danielkopp4/4-bit_Processor/Potential Schematics/Registers for PCB/Multiplexer/Board_render.png

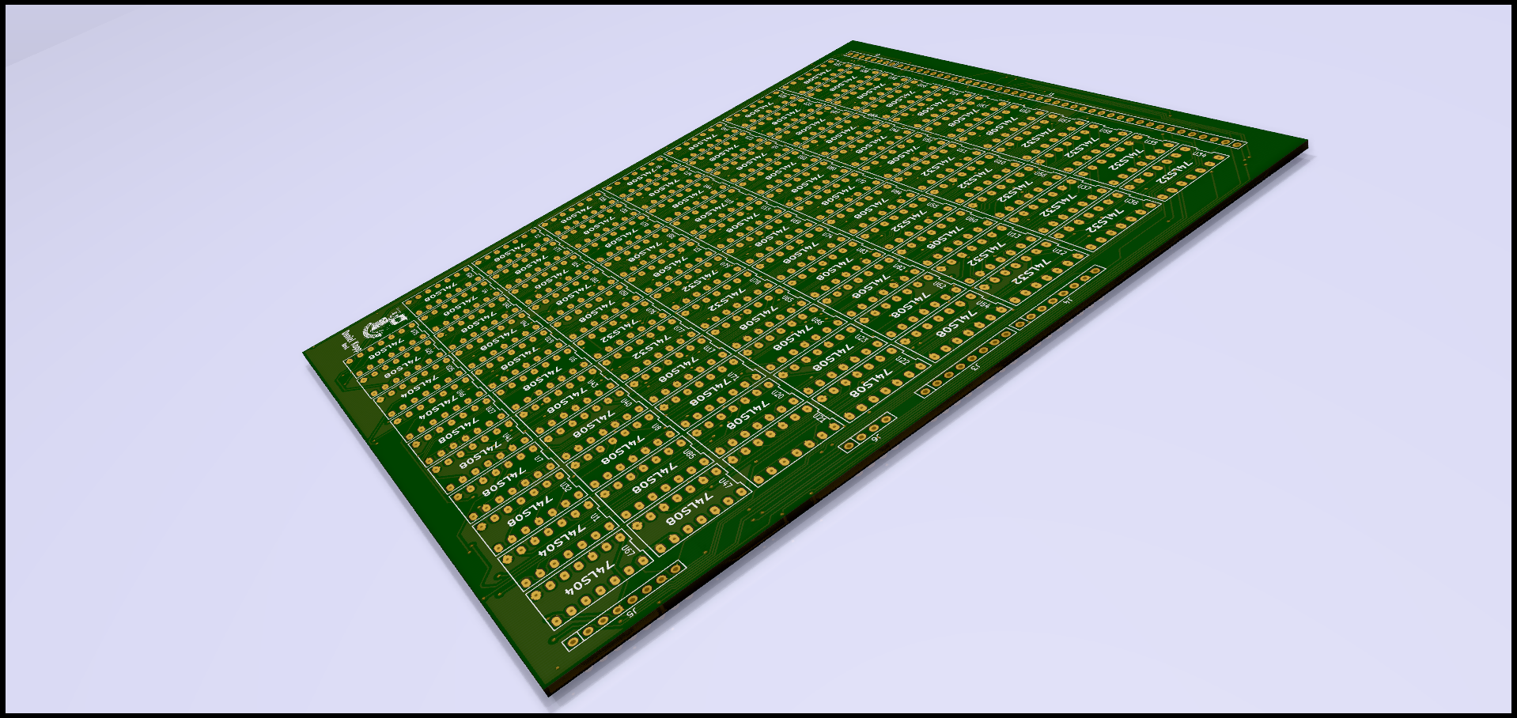
Potential Schematics/Registers for PCB/Multiplexer/Board_render.png
