danielkopp4/4-bit_Processor/(list of files, drawings)

Other design files:
Potential Schematics/Registers for PCB/Multiplexer/Multiplexer.dsn
Potential Schematics/Registers for PCB/Multiplexer/Multiplexer_Final_DSN.dsn
Potential Schematics/Registers for PCB/Multiplexer/Multiplexer_WIth_Better_Edges.dsn
Potential Schematics/Registers for PCB/Multiplexer/Multiplexer_WithEdges.dsn
Potential Schematics/Registers for PCB/Register/Register.dsn
