danielkopp4/4-bit_Processor/Potential Schematics/Registers for PCB/Register/Register.kicad_pcb

## KiCad design Potential Schematics/Registers for PCB/Register/Register.kicad_pcb (2020-09-25)

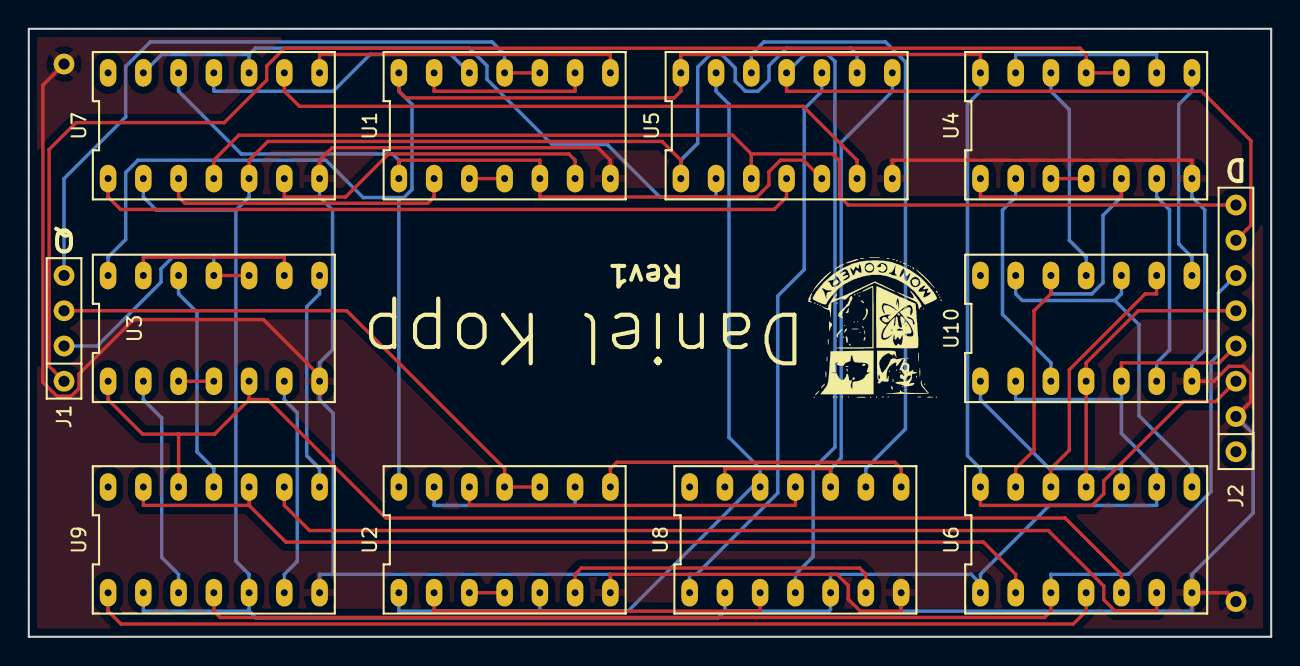
[picture p2: board Register.kicad_pcb from above]

Board: 2 copper layers, 89.5 x 43.8 mm, 15 parts (0 on the bottom side), 51 nets.

Parts:
 : Measurement_Point_Round-TH_Small
 #2: Measurement_Point_Round-TH_Small
 #3: Real_Logo
J1: Conn_01x04_Female; Female_Header_4-pin
J2: Conn_01x08_Female; Female_Header_8-pin
U1, U2, U3, U4: 74LS02; DIP-14_300_ELL
U5, U6: 74LS04; DIP-14_300_ELL
U7, U8, U9, U10: 74LS08; DIP-14_300_ELL

Connections:
/D_Flip-Flop/D_Latch/QN: U1.3, U1.4
/D_Flip-Flop/D_Latch/RS-Latch/R: U1.2, U7.3
/D_Flip-Flop/D_Latch/RS-Latch/S: U1.6, U7.6
/D_Flip-Flop/QN: U1.9, U1.13
/D_Flip-Flop/sheet5BAD013C/C: U5.2, U7.10, U7.13
/D_Flip-Flop/sheet5BAD013C/D: U1.1, U1.5, U5.5, U7.12
/D_Flip-Flop/sheet5BAD013C/RS-Latch/R: U1.8, U7.8
/D_Flip-Flop/sheet5BAD013C/RS-Latch/S: U1.12, U7.11
/sheet5BAD03B0/D_Latch/QN: U2.3, U2.4
/sheet5BAD03B0/D_Latch/RS-Latch/R: U2.2, U8.3
/sheet5BAD03B0/D_Latch/RS-Latch/S: U2.6, U8.6
/sheet5BAD03B0/QN: U2.9, U2.13
/sheet5BAD03B0/sheet5BAD013C/C: U5.8, U8.10, U8.13
/sheet5BAD03B0/sheet5BAD013C/D: U2.1, U2.5, U5.13, U8.12
/sheet5BAD03B0/sheet5BAD013C/RS-Latch/R: U2.8, U8.8
/sheet5BAD03B0/sheet5BAD013C/RS-Latch/S: U2.12, U8.11
/sheet5BAD03B9/D_Latch/QN: U3.3, U3.4
/sheet5BAD03B9/D_Latch/RS-Latch/R: U3.2, U9.3
/sheet5BAD03B9/D_Latch/RS-Latch/S: U3.6, U9.6
/sheet5BAD03B9/QN: U3.9, U3.13
/sheet5BAD03B9/sheet5BAD013C/C: U6.2, U9.10, U9.13
/sheet5BAD03B9/sheet5BAD013C/D: U3.1, U3.5, U6.5, U9.12
/sheet5BAD03B9/sheet5BAD013C/RS-Latch/R: U3.8, U9.8
/sheet5BAD03B9/sheet5BAD013C/RS-Latch/S: U3.12, U9.11
/sheet5BAD03C0/D_Latch/QN: U4.3, U4.4
/sheet5BAD03C0/D_Latch/RS-Latch/R: U4.2, U10.3
/sheet5BAD03C0/D_Latch/RS-Latch/S: U4.6, U10.6
/sheet5BAD03C0/QN: U4.9, U4.13
/sheet5BAD03C0/sheet5BAD013C/C: U6.8, U10.10, U10.13
/sheet5BAD03C0/sheet5BAD013C/D: U4.1, U4.5, U6.13, U10.12
/sheet5BAD03C0/sheet5BAD013C/RS-Latch/R: U4.8, U10.8
/sheet5BAD03C0/sheet5BAD013C/RS-Latch/S: U4.12, U10.11
Clock: J2.4, U5.1, U5.9, U6.1, U6.9, U7.2, U7.5, U8.2, U8.5, U9.2, U9.5, U10.2, U10.5
D0: J2.8, U5.3, U7.4
D1: J2.7, U5.11, U8.4
D2: J2.6, U6.3, U9.4
D3: J2.5, U6.11, U10.4
GND: .1, #2.1, J2.2, U1.7, U2.7, U3.7, U4.7, U5.7, U6.7, U7.7, U8.7, U9.7, U10.7
unnamed: U5.4, U7.1
unnamed: U5.6, U7.9
unnamed: U5.10, U8.1
unnamed: U5.12, U8.9
unnamed: U6.4, U9.1
unnamed: U6.6, U9.9
unnamed: U6.10, U10.1
unnamed: U6.12, U10.9
Q0: J1.4, U1.10, U1.11
Q1: J1.3, U2.10, U2.11
Q2: J1.2, U3.10, U3.11
Q3: J1.1, U4.10, U4.11
VCC: J2.3, U1.14, U2.14, U3.14, U4.14, U5.14, U6.14
