danielkopp4/4-bit_Processor/Potential Schematics/Registers for PCB/Multiplexer/Multiplexer.kicad_pcb

## KiCad design Potential Schematics/Registers for PCB/Multiplexer/Multiplexer.kicad_pcb (2020-09-25)

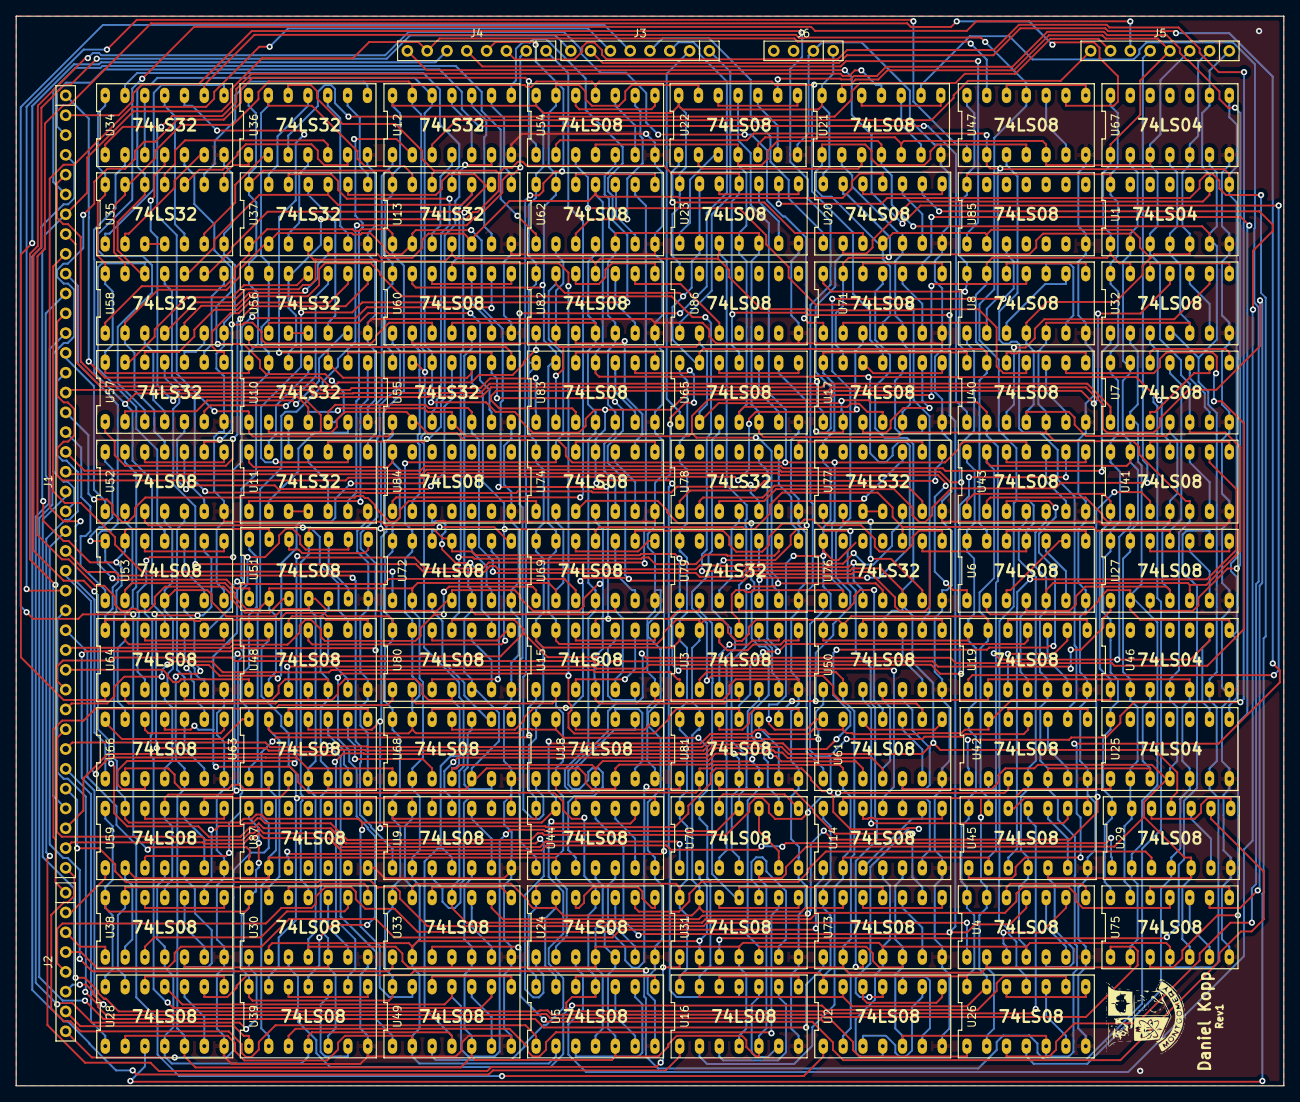
[picture p3: board Multiplexer.kicad_pcb from above]

Board: 2 copper layers, 162.6 x 137.2 mm, 93 parts (0 on the bottom side), 341 nets.

Parts:
J1: Conn_01x40_Female; SIP-40
J2, J3, J4, J5: Conn_01x08_Female; Female_Header_8-pin
J6: Conn_01x04_Female; Female_Header_4-pin
U1, U25, U46, U67: 74LS04; DIP-14_300_ELL
U2, U3, U4, U5, U6, U7, U8, U9, U14, U15, U16, U17, U18, U19, U20, U21, U22, U23, U24, U26, U27, U28, U29, U30, U31, U32, U33, U38, U39, U40, U41, U42, U43, U44, U45, U47, U48, U49, U50, U51, U52, U53, U54, U59, U60, U61, U62, U63, U64, U65, U66, U68, U69, U70, U71, U72, U73, U74, U75, U80, U81, U82, U83, U84, U85, U86, U87: 74LS08; DIP-14_300_ELL
U10, U11, U12, U13, U34, U35, U36, U37, U55, U56, U57, U58, U76, U77, U78, U79: 74LS32; DIP-14_300_ELL

Connections:
/64:4 Multiplexer/16;1_Multiplexer/5:1_AND/b: U1.8, U2.2, U3.2, U4.2, U5.2, U6.2, U7.2, U8.2, U9.2, U25.8, U26.2, U27.2, U28.2, U29.2, U30.2, U31.2, U32.2, U33.2, U46.8, U47.2, U48.2, U49.2, U50.2, U51.2, U52.2, U53.2, U54.2, U67.8, U68.2, U69.2, U70.2, U71.2, U72.2, U73.2, U74.2, U75.2
/64:4 Multiplexer/16;1_Multiplexer/5:1_AND/c: U1.6, U2.4, U3.4, U4.4, U5.4, U14.4, U15.4, U16.4, U17.4, U21.4, U22.4, U23.4, U24.4, U25.6, U30.4, U31.4, U32.4, U33.4, U42.4, U43.4, U44.4, U45.4, U46.6, U51.4, U52.4, U53.4, U54.4, U63.4, U64.4, U65.4, U66.4, U67.6, U72.4, U73.4, U74.4, U75.4
/64:4 Multiplexer/16;1_Multiplexer/5:1_AND/d: U1.4, U4.5, U5.5, U8.5, U9.5, U16.5, U17.5, U20.5, U21.2, U23.5, U24.5, U25.4, U28.5, U29.5, U32.5, U33.5, U40.5, U41.5, U44.5, U45.5, U46.4, U49.5, U50.5, U53.5, U54.5, U61.5, U62.5, U65.5, U66.5, U67.4, U70.5, U71.5, U74.5, U75.5, U82.5, U83.5
/64:4 Multiplexer/16;1_Multiplexer/5:1_AND/e: U1.2, U3.13, U5.13, U7.13, U9.13, U15.13, U17.13, U19.13, U20.13, U22.13, U24.13, U25.2, U27.13, U29.13, U31.13, U33.13, U39.13, U41.13, U43.13, U45.13, U46.2, U48.13, U50.13, U52.13, U54.13, U60.13, U62.13, U64.13, U66.13, U67.2, U69.13, U71.13, U73.13, U75.13, U81.13, U83.13
/64:4 Multiplexer/16;1_Multiplexer/Sheet5BB0E1EE/D0: U5.11, U10.13, U13.13, U24.11, U36.13, U45.11, U56.13, U66.11
/64:4 Multiplexer/16;1_Multiplexer/Sheet5BB0E1EE/D1: U4.11, U10.12, U13.12, U23.11, U36.12, U44.11, U56.12, U65.11
/64:4 Multiplexer/16;1_Multiplexer/Sheet5BB0E1EE/D2: U3.11, U10.2, U22.11, U34.2, U43.11, U55.2, U64.11, U76.2
/64:4 Multiplexer/16;1_Multiplexer/Sheet5BB0E1EE/D3: U2.11, U10.1, U21.11, U34.1, U42.11, U55.1, U63.11, U76.1
/64:4 Multiplexer/16;1_Multiplexer/Sheet5BB0E1EE/D4: U9.11, U10.5, U29.11, U34.5, U50.11, U55.5, U71.11, U76.5
/64:4 Multiplexer/16;1_Multiplexer/Sheet5BB0E1EE/D5: U8.11, U10.4, U28.11, U34.4, U49.11, U55.4, U70.11, U76.4
/64:4 Multiplexer/16;1_Multiplexer/Sheet5BB0E1EE/D6: U7.11, U10.10, U27.11, U34.10, U48.11, U55.10, U69.11, U76.10
/64:4 Multiplexer/16;1_Multiplexer/Sheet5BB0E1EE/D7: U6.11, U10.9, U26.11, U34.9, U47.11, U55.9, U68.11, U76.9
/64:4 Multiplexer/16;1_Multiplexer/Sheet5BB0E1EE/D8: U12.13, U17.11, U33.11, U35.13, U54.11, U55.13, U58.13, U75.11
/64:4 Multiplexer/16;1_Multiplexer/Sheet5BB0E1EE/D9: U12.12, U16.11, U32.11, U35.12, U53.11, U55.12, U58.12, U74.11
/64:4 Multiplexer/16;1_Multiplexer/Sheet5BB0E1EE/Da: U13.2, U15.11, U31.11, U37.2, U52.11, U58.2, U73.11, U79.2
/64:4 Multiplexer/16;1_Multiplexer/Sheet5BB0E1EE/Db: U13.1, U14.11, U30.11, U37.1, U51.11, U58.1, U72.11, U79.1
/64:4 Multiplexer/16;1_Multiplexer/Sheet5BB0E1EE/Dc: U13.5, U20.11, U37.5, U41.11, U58.5, U62.11, U79.5, U83.11
/64:4 Multiplexer/16;1_Multiplexer/Sheet5BB0E1EE/Dd: U13.4, U23.3, U37.4, U40.11, U58.4, U61.11, U79.4, U82.11
/64:4 Multiplexer/16;1_Multiplexer/Sheet5BB0E1EE/De: U13.10, U19.11, U37.10, U39.11, U58.10, U60.11, U79.10, U81.11
/64:4 Multiplexer/16;1_Multiplexer/Sheet5BB0E1EE/Df: U13.9, U18.11, U37.9, U38.11, U58.9, U59.11, U79.9, U80.11
/64:4 Multiplexer/D00: J1.40, U5.1
/64:4 Multiplexer/D01: J1.39, U29.1
/64:4 Multiplexer/D02: J1.38, U50.1
/64:4 Multiplexer/D03: J1.37, U71.1
/64:4 Multiplexer/D10: J1.36, U4.1
/64:4 Multiplexer/D11: J1.35, U28.1
/64:4 Multiplexer/D12: J1.34, U49.1
/64:4 Multiplexer/D13: J1.33, U70.1
/64:4 Multiplexer/D20: J1.32, U3.1
/64:4 Multiplexer/D21: J1.31, U27.1
/64:4 Multiplexer/D22: J1.30, U48.1
/64:4 Multiplexer/D23: J1.29, U69.1
/64:4 Multiplexer/D30: J1.28, U2.1
/64:4 Multiplexer/D31: J1.27, U26.1
/64:4 Multiplexer/D32: J1.26, U47.1
/64:4 Multiplexer/D33: J1.25, U68.1
/64:4 Multiplexer/D40: J1.24, U9.1
/64:4 Multiplexer/D41: J1.23, U33.1
/64:4 Multiplexer/D42: J1.22, U54.1
/64:4 Multiplexer/D43: J1.21, U75.1
/64:4 Multiplexer/D50: J1.20, U8.1
/64:4 Multiplexer/D51: J1.19, U32.1
/64:4 Multiplexer/D52: J1.18, U53.1
/64:4 Multiplexer/D53: J1.17, U74.1
/64:4 Multiplexer/D60: J1.16, U7.1
/64:4 Multiplexer/D61: J1.15, U31.1
/64:4 Multiplexer/D62: J1.14, U52.1
/64:4 Multiplexer/D63: J1.13, U73.1
/64:4 Multiplexer/D70: J1.12, U6.1
/64:4 Multiplexer/D71: J1.11, U30.1
/64:4 Multiplexer/D72: J1.10, U51.1
/64:4 Multiplexer/D73: J1.9, U72.1
/64:4 Multiplexer/D80: J1.8, U17.1
/64:4 Multiplexer/D81: J1.7, J4.7, U41.1, U42.13, U43.1, U44.13, U46.1, U47.13, U49.13, U51.13, U53.13, U59.13, U61.13
/64:4 Multiplexer/D82: J1.6, U62.1
/64:4 Multiplexer/D83: J1.5, U83.1
/64:4 Multiplexer/D90: J1.4, U16.1
/64:4 Multiplexer/D91: J1.3, U40.1
/64:4 Multiplexer/D92: J1.2, U61.1
/64:4 Multiplexer/D93: J1.1, U82.1
/64:4 Multiplexer/Da0: J2.8, U15.1
/64:4 Multiplexer/Da1: J2.7, U39.1
/64:4 Multiplexer/Da2: J2.6, U60.1
/64:4 Multiplexer/Da3: J2.5, U81.1
/64:4 Multiplexer/Db0: J2.4, U14.1
/64:4 Multiplexer/Db1: J2.3, U38.1
/64:4 Multiplexer/Db2: J2.2, U59.1
/64:4 Multiplexer/Db3: J2.1, U80.1
/64:4 Multiplexer/Dc0: J3.8, U24.1
/64:4 Multiplexer/Dc1: J3.7, U45.1
/64:4 Multiplexer/Dc2: J3.6, U66.1
/64:4 Multiplexer/Dc3: J3.5, U87.1
/64:4 Multiplexer/Dd0: J3.4, U20.1
/64:4 Multiplexer/Dd1: J3.3, U44.1
/64:4 Multiplexer/Dd2: J3.2, U65.1
/64:4 Multiplexer/Dd3: J3.1, U86.1
/64:4 Multiplexer/De0: J4.8, U19.1
/64:4 Multiplexer/De2: J4.6, U64.1
/64:4 Multiplexer/De3: J4.5, U85.1
/64:4 Multiplexer/Df0: J4.4, U18.1
/64:4 Multiplexer/Df1: J4.3, U42.1
/64:4 Multiplexer/Df2: J4.2, U63.1
/64:4 Multiplexer/Df3: J4.1, U84.1
/64:4 Multiplexer/Q0: J5.8, U12.3
/64:4 Multiplexer/Q1: J5.7, U36.3
/64:4 Multiplexer/Q2: J5.6, U57.3
/64:4 Multiplexer/Q3: J5.5, U78.3
/64:4 Multiplexer/S0: J5.4, U1.1, U2.13, U4.13, U6.13, U8.13, U14.13, U16.13, U18.13, U21.13, U23.2, U23.13, U25.1, U26.13, U28.13, U30.13, U32.13, U38.13, U40.13, U63.13, U65.13, U67.1, U68.13, U70.13, U72.13, U74.13, U80.13, U82.13
/64:4 Multiplexer/S1: J5.3, U1.3, U2.5, U3.5, U6.5, U7.5, U14.5, U15.5, U18.5, U19.5, U21.5, U22.5, U25.3, U26.5, U27.5, U30.5, U31.5, U38.5, U39.5, U42.5, U43.5, U46.3, U47.5, U48.5, U51.5, U52.5, U59.5, U60.5, U63.5, U64.5, U67.3, U68.5, U69.5, U72.5, U73.5, U80.5, U81.5
/64:4 Multiplexer/S2: J5.2, U1.5, U6.4, U7.4, U8.4, U9.4, U18.4, U19.2, U19.4, U20.4, U21.1, U25.5, U26.4, U27.4, U28.4, U29.4, U38.4, U39.4, U40.4, U41.4, U43.2, U46.5, U47.4, U48.4, U49.4, U50.4, U59.4, U60.4, U61.4, U62.4, U64.2, U67.5, U68.4, U69.4, U70.4, U71.4, U80.4, U81.4, U82.4, U83.4, U85.2
/64:4 Multiplexer/S3: J5.1, U1.9, U14.2, U15.2, U16.2, U17.2, U18.2, U20.2, U24.2, U25.9, U38.2, U39.2, U40.2, U41.2, U42.2, U44.2, U45.2, U46.9, U59.2, U60.2, U61.2, U62.2, U63.2, U65.2, U66.2, U67.9, U80.2, U81.2, U82.2, U83.2, U84.2, U86.2, U87.2
GND: J6.2, U1.7, U2.7, U3.7, U4.7, U5.7, U6.7, U7.7, U8.7, U9.7, U10.7, U11.7, U12.7, U13.7, U14.7, U15.7, U16.7, U17.7, U18.7, U19.7, U20.7, U21.7, U22.7, U23.7, U24.7, U25.7, U26.7, U27.7, U28.7, U29.7, U30.7, U31.7, U32.7, U33.7, U34.7, U35.7, U36.7, U37.7, U38.7, U39.7, U40.7, U41.7, U42.7, U43.7, U44.7, U45.7, U46.7, U47.7, U48.7, U49.7, U50.7, U51.7, U52.7, U53.7, U54.7, U55.7, U56.7, U57.7, U58.7, U59.7, U60.7, U61.7, U62.7, U63.7, U64.7, U65.7, U66.7, U67.7, U68.7, U69.7, U70.7, U71.7, U72.7, U73.7, U74.7, U75.7, U76.7, U77.7, U78.7, U79.7, U80.7, U81.7, U82.7, U83.7, U84.7, U85.7, U86.7, U87.7
unnamed: U2.3, U2.9
unnamed: U2.6, U2.10
unnamed: U2.8, U2.12
unnamed: U3.3, U3.9
unnamed: U3.6, U3.10
unnamed: U3.8, U3.12
unnamed: U4.3, U4.9
unnamed: U4.6, U4.10
unnamed: U4.8, U4.12
unnamed: U5.3, U5.9
unnamed: U5.6, U5.10
unnamed: U5.8, U5.12
unnamed: U6.3, U6.9
unnamed: U6.6, U6.10
unnamed: U6.8, U6.12
unnamed: U7.3, U7.9
unnamed: U7.6, U7.10
unnamed: U7.8, U7.12
unnamed: U8.3, U8.9
unnamed: U8.6, U8.10
unnamed: U8.8, U8.12
unnamed: U9.3, U9.9
unnamed: U9.6, U9.10
unnamed: U9.8, U9.12
unnamed: U10.3, U11.12
unnamed: U10.6, U11.2
unnamed: U10.8, U11.1
unnamed: U10.11, U11.13
unnamed: U11.3, U11.4
unnamed: U11.6, U12.2
unnamed: U11.8, U12.1
unnamed: U11.9, U12.8
unnamed: U11.10, U12.6
unnamed: U11.5, U11.11
unnamed: U12.4, U13.3
unnamed: U12.9, U13.8
unnamed: U12.10, U13.6
unnamed: U12.5, U12.11
unnamed: U13.11, U34.13
unnamed: U14.3, U14.9
unnamed: U14.6, U14.10
unnamed: U14.8, U14.12
unnamed: U15.3, U15.9
unnamed: U15.6, U15.10
unnamed: U15.8, U15.12
unnamed: U16.3, U16.9
unnamed: U16.6, U16.10
unnamed: U16.8, U16.12
unnamed: U17.3, U17.9
unnamed: U17.6, U17.10
unnamed: U17.8, U17.12
unnamed: U18.3, U18.9
unnamed: U18.6, U18.10
unnamed: U18.8, U18.12
unnamed: U19.3, U19.9
unnamed: U19.6, U19.10
unnamed: U19.8, U19.12
unnamed: U20.3, U22.1
unnamed: U20.9, U24.3
unnamed: U20.6, U20.10
unnamed: U20.8, U20.12
unnamed: U21.3, U22.2
unnamed: U21.9, U26.3
unnamed: U21.6, U21.10
unnamed: U21.8, U21.12
unnamed: U22.3, U23.1
unnamed: U22.9, U27.3
unnamed: U22.6, U22.10
unnamed: U22.8, U22.12
unnamed: U23.9, U28.3
unnamed: U23.6, U23.10
unnamed: U23.8, U23.12
unnamed: U24.9, U29.3
unnamed: U24.6, U24.10
unnamed: U24.8, U24.12
unnamed: U26.9, U30.3
unnamed: U26.6, U26.10
unnamed: U26.8, U26.12
unnamed: U27.9, U31.3
unnamed: U27.6, U27.10
unnamed: U27.8, U27.12
unnamed: U28.9, U32.3
unnamed: U28.6, U28.10
unnamed: U28.8, U28.12
unnamed: U29.9, U33.3
unnamed: U29.6, U29.10
unnamed: U29.8, U29.12
unnamed: U30.9, U38.3
unnamed: U30.6, U30.10
unnamed: U30.8, U30.12
unnamed: U31.9, U39.3
unnamed: U31.6, U31.10
unnamed: U31.8, U31.12
unnamed: U32.9, U40.3
unnamed: U32.6, U32.10
unnamed: U32.8, U32.12
unnamed: U33.9, U41.3
unnamed: U33.6, U33.10
unnamed: U33.8, U33.12
unnamed: U34.6, U35.2
unnamed: U34.8, U35.1
unnamed: U34.11, U35.5
unnamed: U34.3, U34.12
unnamed: U35.3, U35.4
unnamed: U35.6, U36.2
unnamed: U35.8, U36.1
unnamed: U35.9, U36.8
unnamed: U35.10, U36.6
unnamed: U35.11, U36.5
unnamed: U36.4, U37.3
unnamed: U36.9, U37.8
unnamed: U36.10, U37.6
unnamed: U36.11, U37.13
unnamed: U37.11, U56.5
unnamed: U37.12, U55.3
unnamed: U38.9, U42.3
unnamed: U38.6, U38.10
unnamed: U38.8, U38.12
unnamed: U39.9, U43.3
unnamed: U39.6, U39.10
unnamed: U39.8, U39.12
unnamed: U40.9, U44.3
unnamed: U40.6, U40.10
unnamed: U40.8, U40.12
unnamed: U41.9, U45.3
unnamed: U41.6, U41.10
unnamed: U41.8, U41.12
unnamed: U42.9, U47.3
unnamed: U42.6, U42.10
unnamed: U42.8, U42.12
unnamed: U43.9, U48.3
unnamed: U43.6, U43.10
unnamed: U43.8, U43.12
unnamed: U44.9, U49.3
unnamed: U44.6, U44.10
unnamed: U44.8, U44.12
unnamed: U45.9, U50.3
unnamed: U45.6, U45.10
unnamed: U45.8, U45.12
unnamed: U47.9, U51.3
unnamed: U47.6, U47.10
unnamed: U47.8, U47.12
unnamed: U48.9, U52.3
unnamed: U48.6, U48.10
unnamed: U48.8, U48.12
unnamed: U49.9, U53.3
unnamed: U49.6, U49.10
unnamed: U49.8, U49.12
unnamed: U50.9, U54.3
unnamed: U50.6, U50.10
unnamed: U50.8, U50.12
unnamed: U51.9, U59.3
unnamed: U51.6, U51.10
unnamed: U51.8, U51.12
unnamed: U52.9, U60.3
unnamed: U52.6, U52.10
unnamed: U52.8, U52.12
unnamed: U53.9, U61.3
unnamed: U53.6, U53.10
unnamed: U53.8, U53.12
unnamed: U54.9, U62.3
unnamed: U54.6, U54.10
unnamed: U54.8, U54.12
unnamed: U55.6, U56.2
unnamed: U55.8, U56.1
unnamed: U55.11, U57.5
unnamed: U56.3, U56.4
unnamed: U56.6, U57.2
unnamed: U56.8, U57.1
unnamed: U56.9, U57.8
unnamed: U56.10, U57.6
unnamed: U56.11, U57.13
unnamed: U57.4, U58.3
unnamed: U57.9, U58.8
unnamed: U57.10, U58.6
unnamed: U57.11, U77.5
unnamed: U57.12, U76.3
unnamed: U58.11, U78.5
unnamed: U59.9, U63.3
unnamed: U59.6, U59.10
unnamed: U59.8, U59.12
unnamed: U60.9, U64.3
unnamed: U60.6, U60.10
unnamed: U60.8, U60.12
unnamed: U61.9, U65.3
unnamed: U61.6, U61.10
unnamed: U61.8, U61.12
unnamed: U62.9, U66.3
unnamed: U62.6, U62.10
unnamed: U62.8, U62.12
unnamed: U63.9, U68.3
unnamed: U63.6, U63.10
unnamed: U63.8, U63.12
unnamed: U64.9, U69.3
unnamed: U64.6, U64.10
unnamed: U64.8, U64.12
unnamed: U65.9, U70.3
unnamed: U65.6, U65.10
unnamed: U65.8, U65.12
unnamed: U66.9, U71.3
unnamed: U66.6, U66.10
unnamed: U66.8, U66.12
unnamed: U68.9, U72.3
unnamed: U68.6, U68.10
unnamed: U68.8, U68.12
unnamed: U69.9, U73.3
unnamed: U69.6, U69.10
unnamed: U69.8, U69.12
unnamed: U70.9, U74.3
unnamed: U70.6, U70.10
unnamed: U70.8, U70.12
unnamed: U71.9, U75.3
unnamed: U71.6, U71.10
unnamed: U71.8, U71.12
unnamed: U72.9, U80.3
unnamed: U72.6, U72.10
unnamed: U72.8, U72.12
unnamed: U73.9, U81.3
unnamed: U73.6, U73.10
unnamed: U73.8, U73.12
unnamed: U74.9, U82.3
unnamed: U74.6, U74.10
unnamed: U74.8, U74.12
unnamed: U75.9, U83.3
unnamed: U75.6, U75.10
unnamed: U75.8, U75.12
unnamed: U76.6, U77.2
unnamed: U76.8, U77.1
unnamed: U77.3, U77.4
unnamed: U77.6, U78.2
unnamed: U77.8, U78.1
unnamed: U77.9, U78.8
unnamed: U77.10, U78.6
unnamed: U78.4, U79.3
unnamed: U78.9, U79.8
unnamed: U78.10, U79.6
unnamed: U80.9, U84.3
unnamed: U80.6, U80.10
unnamed: U80.8, U80.12
unnamed: U81.9, U85.3
unnamed: U81.6, U81.10
unnamed: U81.8, U81.12
unnamed: U82.9, U86.3
unnamed: U82.6, U82.10
unnamed: U82.8, U82.12
unnamed: U83.9, U87.3
unnamed: U83.6, U83.10
unnamed: U83.8, U83.12
VCC: J6.1, U1.14, U2.14, U3.14, U4.14, U5.14, U6.14, U7.14, U8.14, U9.14, U10.14, U11.14, U12.14, U13.14, U14.14, U15.14, U16.14, U17.14, U18.14, U19.14, U20.14, U21.14, U22.14, U23.14, U24.14, U25.14, U26.14, U27.14, U28.14, U29.14, U30.14, U31.14, U32.14, U33.14, U34.14, U35.14, U36.14, U37.14, U38.14, U39.14, U40.14, U41.14, U42.14, U43.14, U44.14, U45.14, U46.14, U47.14, U48.14, U49.14, U50.14, U51.14, U52.14, U53.14, U54.14, U55.14, U56.14, U57.14, U58.14, U59.14, U60.14, U61.14, U62.14, U63.14, U64.14, U65.14, U66.14, U67.14, U68.14, U69.14, U70.14, U71.14, U72.14, U73.14, U74.14, U75.14, U76.14, U77.14, U78.14, U79.14, U80.14, U81.14, U82.14, U83.14, U84.14, U85.14, U86.14, U87.14
