danielkopp4/4-bit_Processor/Potential Schematics/rescue-backup/1-2_Multiplexer-2018-09-18-09-34-03.sch

## KiCad design Potential Schematics/rescue-backup/1-2_Multiplexer-2018-09-18-09-34-03.sch (2020-09-25)

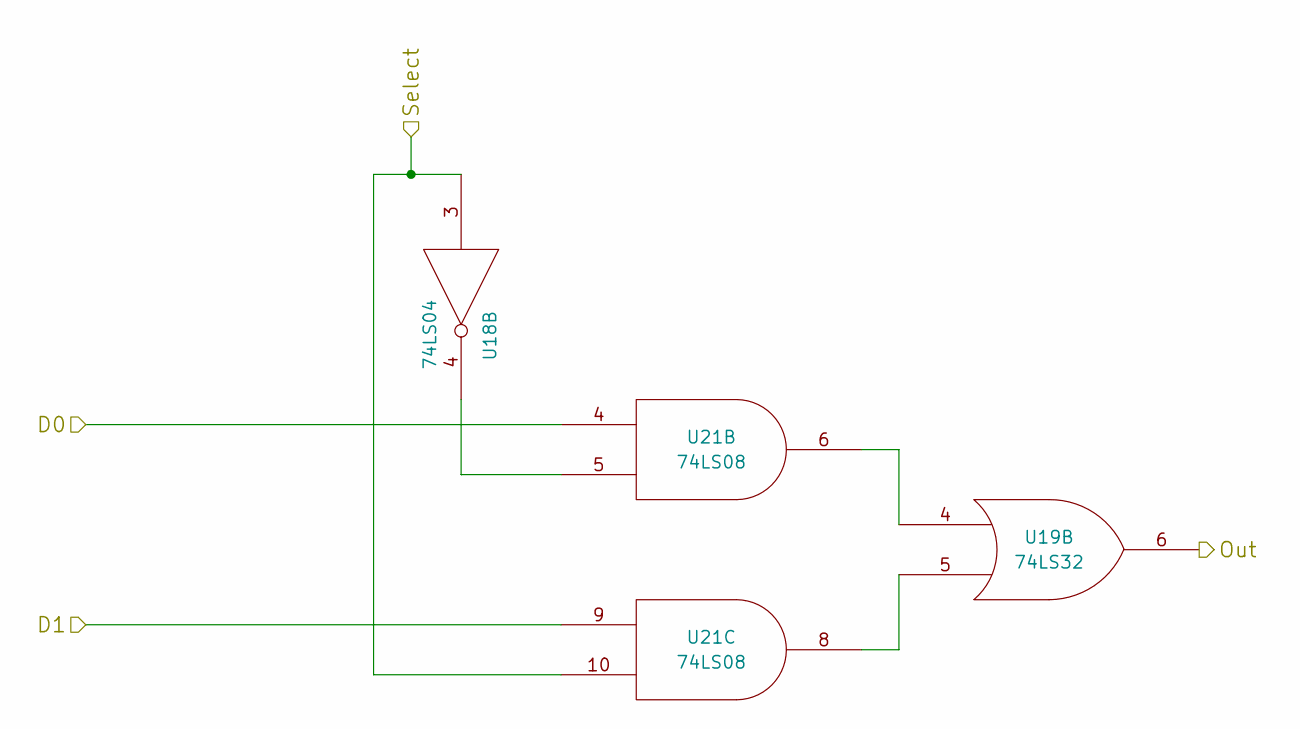
[picture p4: schematic 1-2_Multiplexer-2018-09-18-09-34-03.sch]

Parts:
U1: 74LS04
U2, U5: 74LS08
U3: 74LS32

Connections:
D0: U2.4
D1: U5.9
unnamed: U1.4, U2.5
unnamed: U2.6, U3.4
unnamed: U3.5, U5.8
Out: U3.6
Select: U1.3, U5.10
