danielkopp4/4-bit_Processor/Potential Schematics/rescue-backup/2-4_Multiplexer-2018-09-18-09-34-03.sch

## KiCad design Potential Schematics/rescue-backup/2-4_Multiplexer-2018-09-18-09-34-03.sch (2020-09-25)

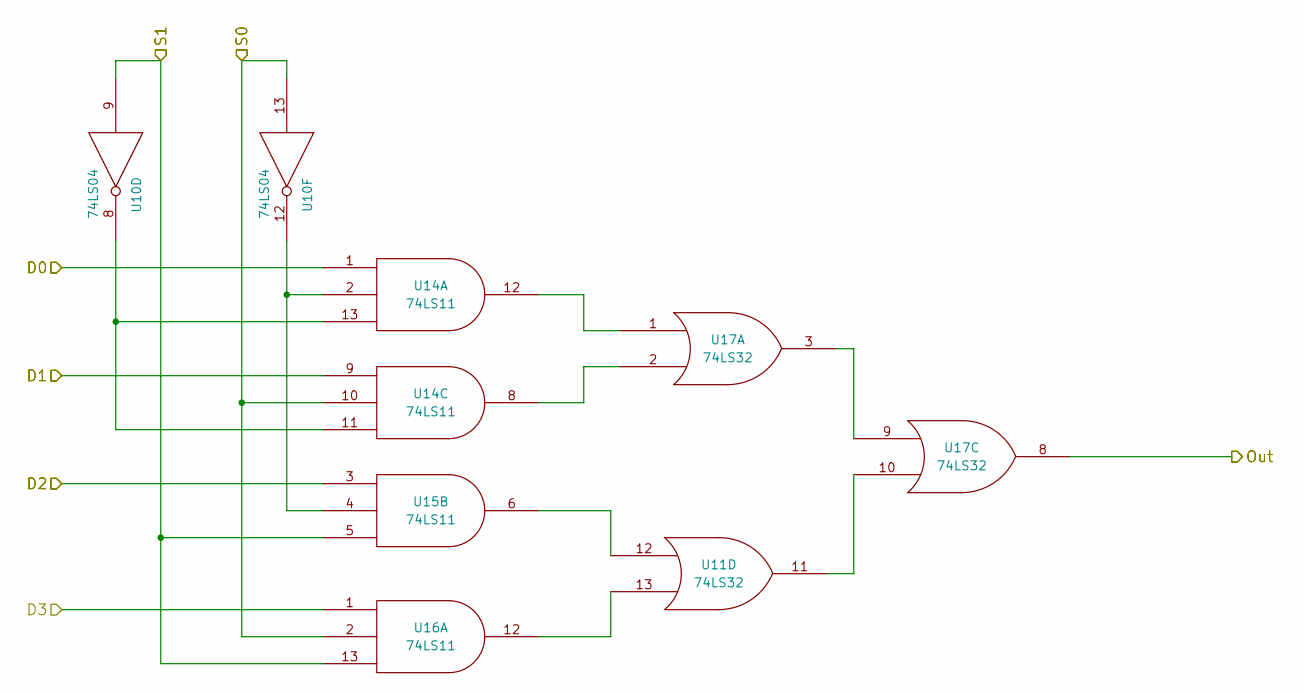
[picture p5: schematic 2-4_Multiplexer-2018-09-18-09-34-03.sch]

Parts:
U1: 74LS04
U3, U9: 74LS32
U6, U7, U8: 74LS11

Connections:
D0: U6.1
D1: U7.9
D2: U7.3
D3: U8.1
unnamed: U1.8, U6.13, U7.11
unnamed: U1.12, U6.2, U7.4
unnamed: U3.11, U9.10
unnamed: U3.12, U7.6
unnamed: U3.13, U8.12
unnamed: U6.12, U9.1
unnamed: U7.8, U9.2
unnamed: U9.3, U9.9
Out: U9.8
S0: U1.13, U7.10, U8.2
S1: U1.9, U7.5, U8.13
