danielkopp4/4-bit_Processor/Potential Schematics/rescue-backup/4-16_Decoder-2018-09-18-09-34-03.sch

## KiCad design Potential Schematics/rescue-backup/4-16_Decoder-2018-09-18-09-34-03.sch (2020-09-25)

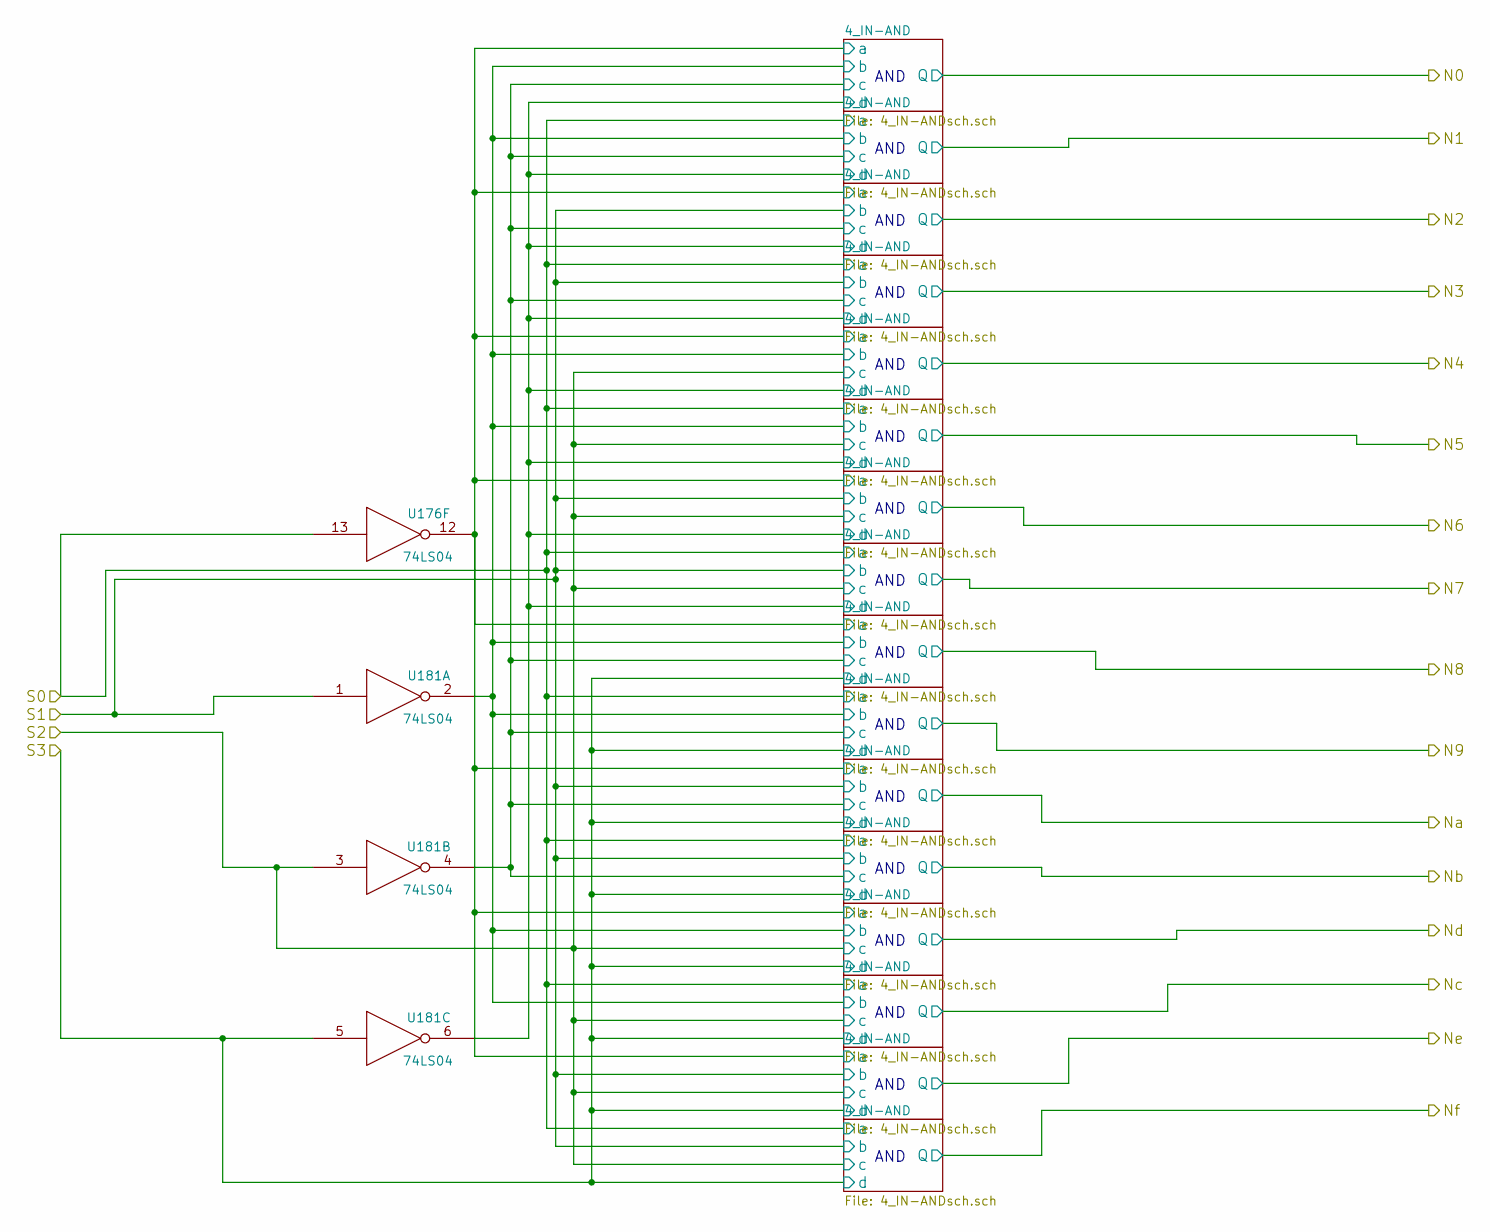
[picture p6: schematic 4-16_Decoder-2018-09-18-09-34-03.sch]

Parts:
U176, U181: 74LS04

Connections:
S0: U176.13
S1: U181.1
S2: U181.3
S3: U181.5
a: U176.12
b: U181.2
c: U181.4
d: U181.6

Notes on the sheet:
AND
