danielkopp4/4-bit_Processor/Potential Schematics/rescue-backup/5-1_AND-2018-09-18-09-34-03.sch

## KiCad design Potential Schematics/rescue-backup/5-1_AND-2018-09-18-09-34-03.sch (2020-09-25)

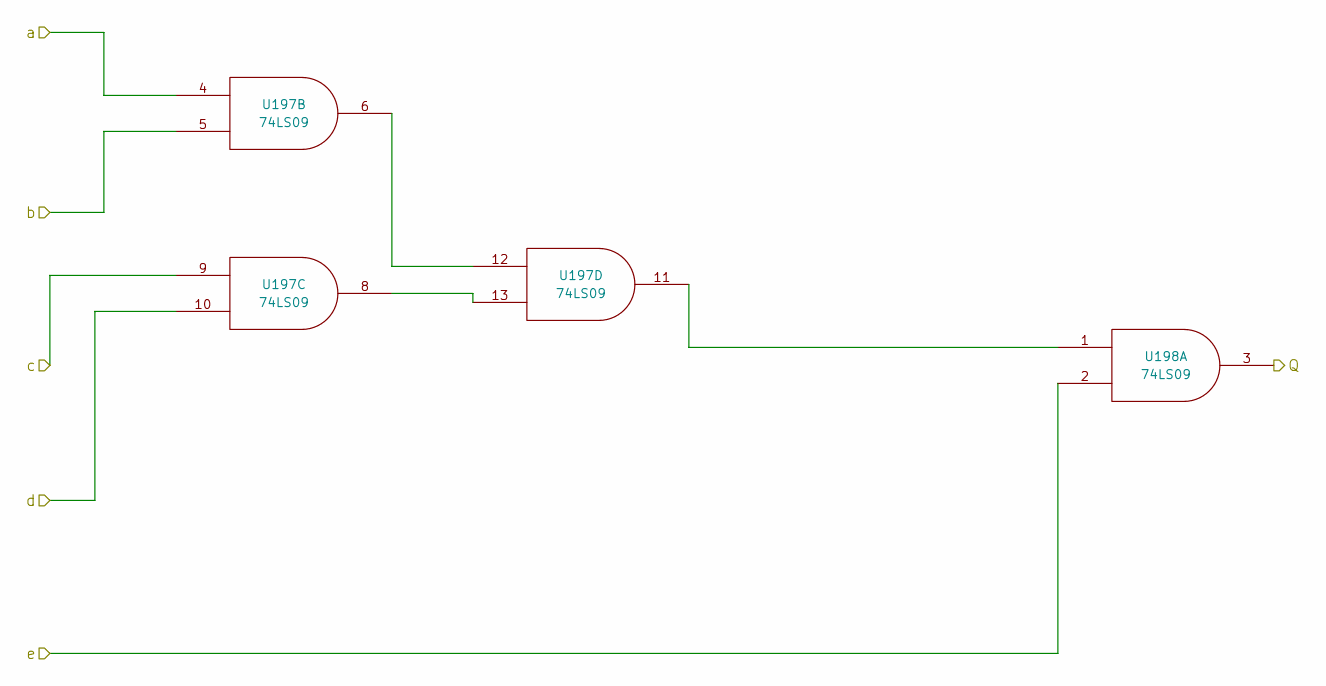
[picture p7: schematic 5-1_AND-2018-09-18-09-34-03.sch]

Parts:
U193, U195: 74LS09

Connections:
unnamed: U193.11, U195.1
unnamed: U193.6, U193.12
unnamed: U193.8, U193.13
Q: U195.3
a: U193.4
b: U193.5
c: U193.9
d: U193.10
e: U195.2
