danielkopp4/4-bit_Processor/Potential Schematics/rescue-backup/16-1_Multiplexer-2018-09-18-09-34-03.sch

## KiCad design Potential Schematics/rescue-backup/16-1_Multiplexer-2018-09-18-09-34-03.sch (2020-09-25)

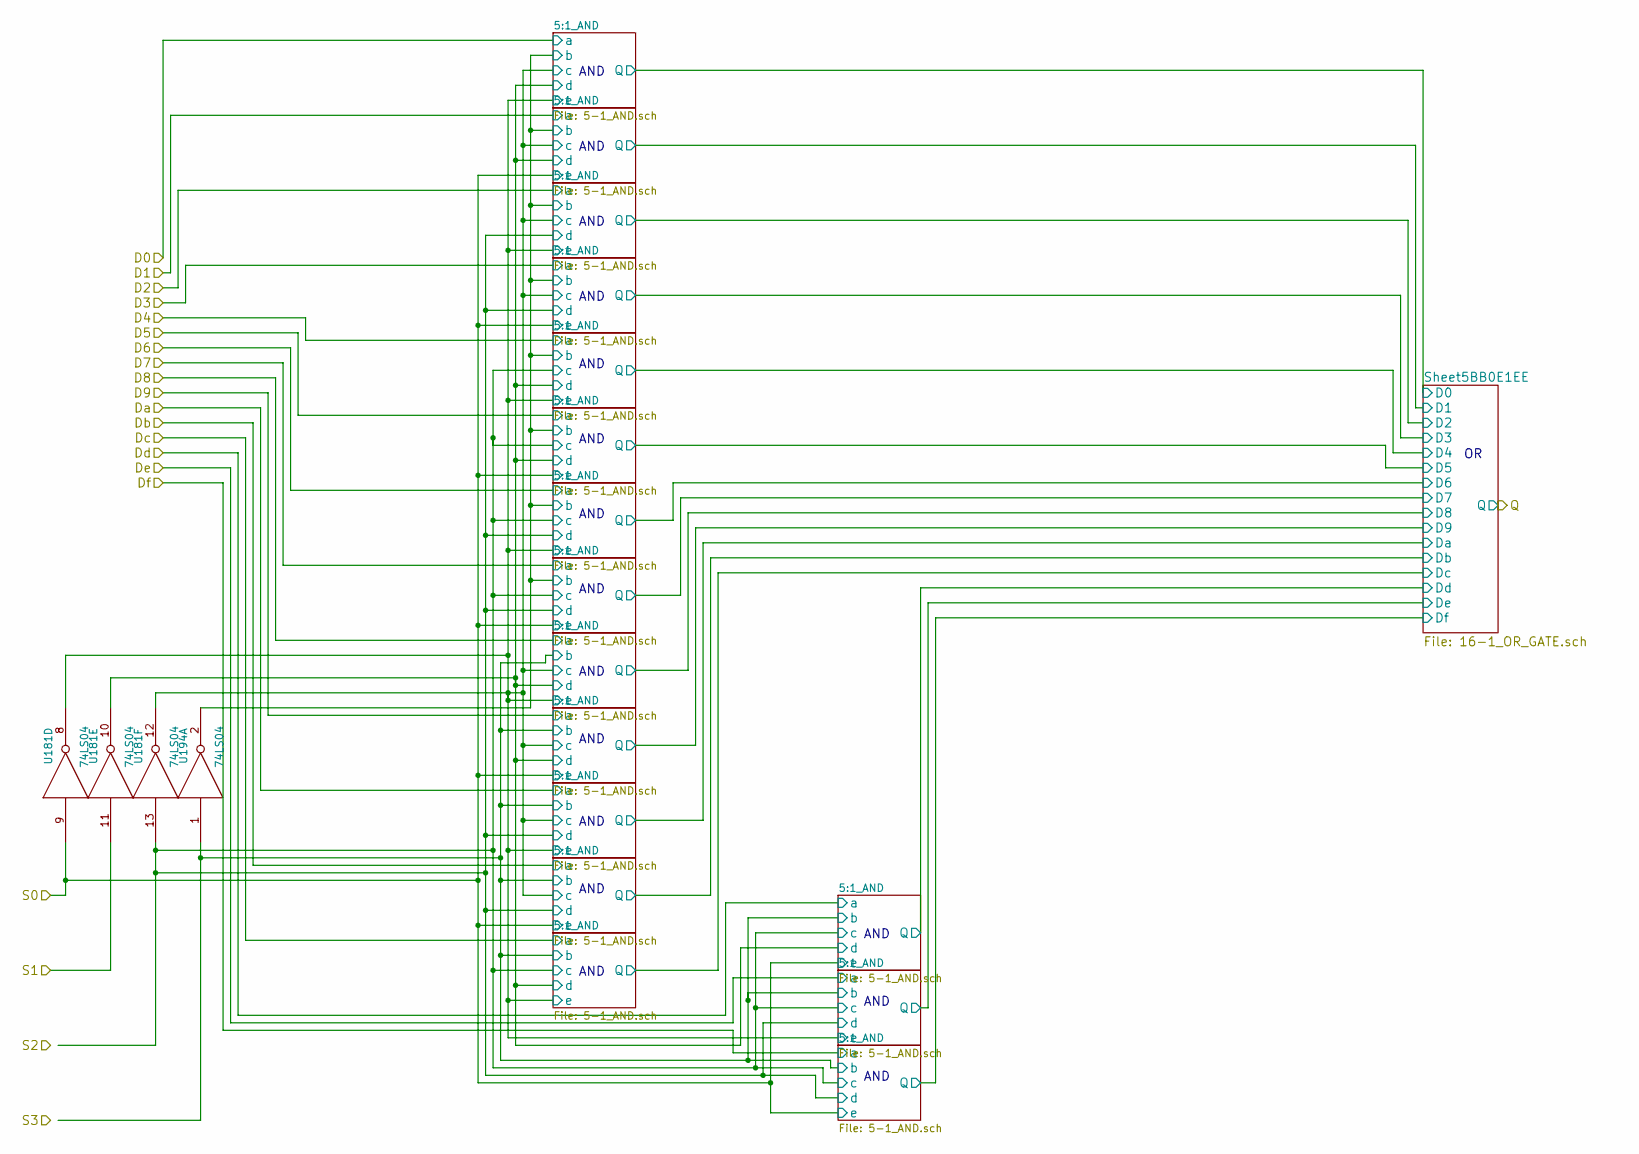
[picture p8: schematic 16-1_Multiplexer-2018-09-18-09-34-03.sch]

Parts:
U181, U194: 74LS04

Connections:
S0: U181.9
S1: U181.11
b: U194.1, U194.2
c: U181.8, U181.12
d: U181.10, U181.13

Notes on the sheet:
AND
