danielkopp4/4-bit_Processor/Potential Schematics/rescue-backup/16-1_OR_GATE-2018-09-18-09-34-03.sch

## KiCad design Potential Schematics/rescue-backup/16-1_OR_GATE-2018-09-18-09-34-03.sch (2020-09-25)

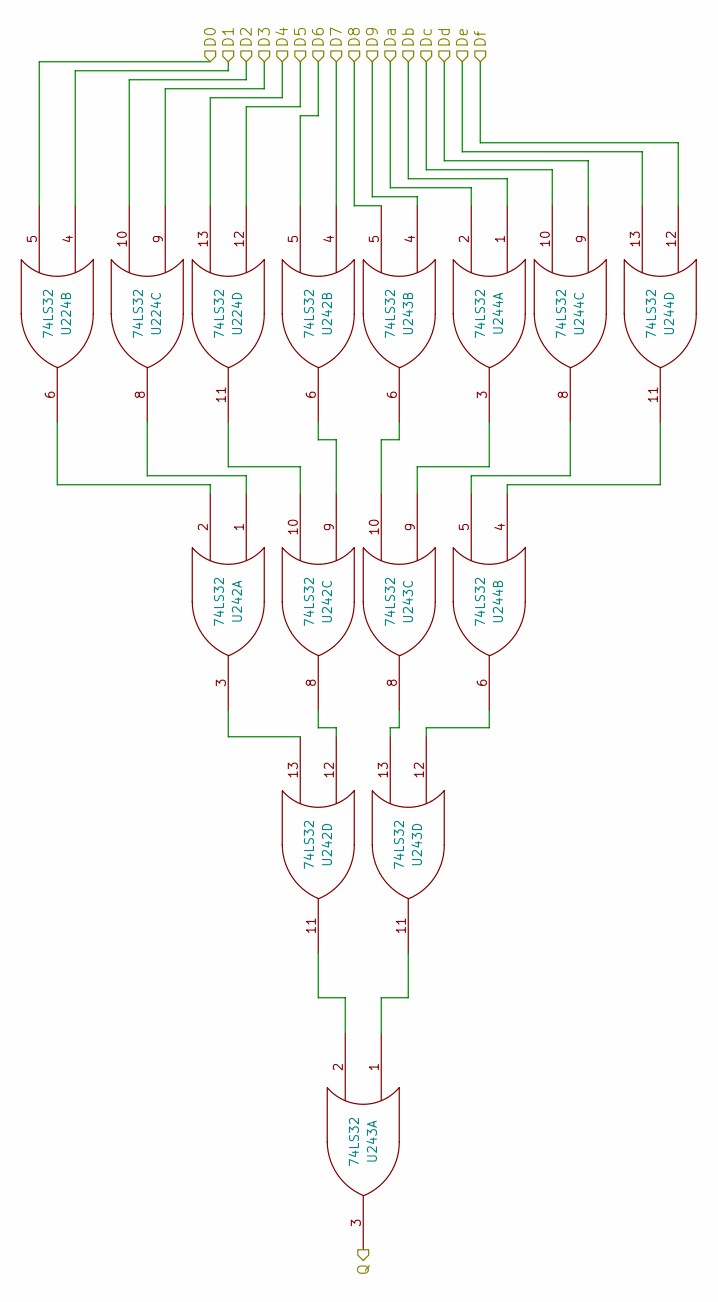
[picture p9: schematic 16-1_OR_GATE-2018-09-18-09-34-03.sch]

Parts:
U11, U17, U19, U36, U203, U204: 74LS32

Connections:
D0: U11.5
D1: U11.4
D2: U11.10
D3: U11.9
D4: U19.13
D5: U19.12
D6: U19.5
D7: U19.4
D8: U36.5
D9: U36.4
Da: U203.2
Db: U203.1
Dc: U204.10
Dd: U204.9
De: U204.13
Df: U204.12
unnamed: U11.6, U19.2
unnamed: U11.8, U19.1
unnamed: U17.9, U19.6
unnamed: U17.10, U19.11
unnamed: U17.11, U36.2
unnamed: U17.8, U17.12
unnamed: U17.13, U19.3
unnamed: U203.3, U203.9
unnamed: U203.4, U204.11
unnamed: U203.5, U204.8
unnamed: U36.6, U203.10
unnamed: U36.1, U203.11
unnamed: U203.6, U203.12
unnamed: U203.8, U203.13
Q: U36.3
