danielkopp4/4-bit_Processor/Potential Schematics/rescue-backup/D_Latch-2018-09-18-09-34-03.sch

## KiCad design Potential Schematics/rescue-backup/D_Latch-2018-09-18-09-34-03.sch (2020-09-25)

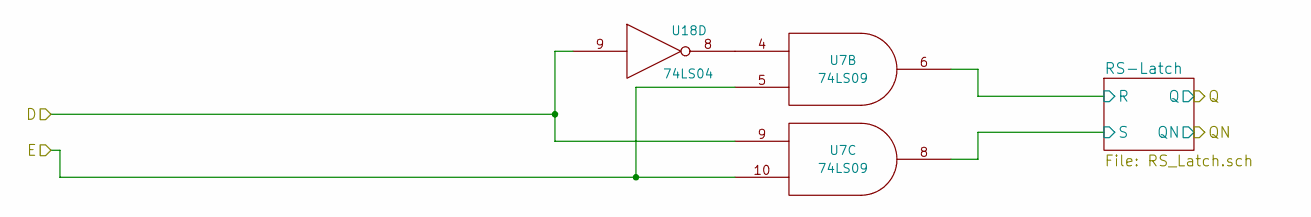
[picture p10: schematic D_Latch-2018-09-18-09-34-03.sch]

Parts:
U7: 74LS09
U18: 74LS04

Connections:
D: U7.9, U18.9
E: U7.5, U7.10
unnamed: U7.4, U18.8
R: U7.6
S: U7.8
