danielkopp4/4-bit_Processor/Potential Schematics/rescue-backup/Full_adder-2018-09-18-09-34-03.sch

## KiCad design Potential Schematics/rescue-backup/Full_adder-2018-09-18-09-34-03.sch (2020-09-25)

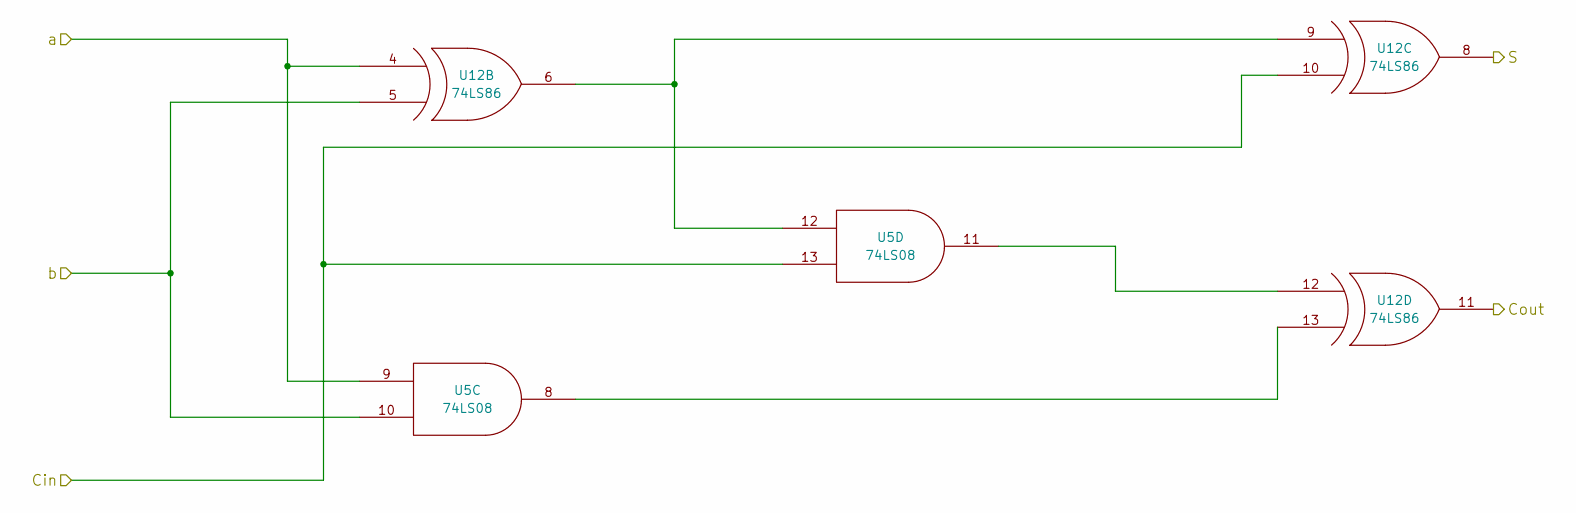
[picture p11: schematic Full_adder-2018-09-18-09-34-03.sch]

Parts:
U2: 74LS08
U4: 74LS86

Connections:
Cin: U2.13, U4.10 (IN2)
Cout: U4.11 (OUT)
unnamed: U2.8, U4.13 (IN2)
unnamed: U2.11, U4.12 (IN1)
unnamed: U2.12, U4.6 (OUT), U4.9 (IN1)
S: U4.8 (OUT)
a: U2.9, U4.4 (IN1)
b: U2.10, U4.5 (IN2)
