danielkopp4/4-bit_Processor/Potential Schematics/rescue-backup/Integer_Overflow_Handler-2018-09-18-09-34-03.sch

## KiCad design Potential Schematics/rescue-backup/Integer_Overflow_Handler-2018-09-18-09-34-03.sch (2020-09-25)

Schematic: Integer_Overflow_Handler-2018-09-18-09-34-03.sch

Parts:
D1: LED
R1: R
SW1: SW_Push
U5, U21, U35: 74LS08
U10: 74LS04
