danielkopp4/4-bit_Processor/Potential Schematics/rescue-backup/Registers-2018-09-18-09-34-03.sch

## KiCad design Potential Schematics/rescue-backup/Registers-2018-09-18-09-34-03.sch (2020-09-25)

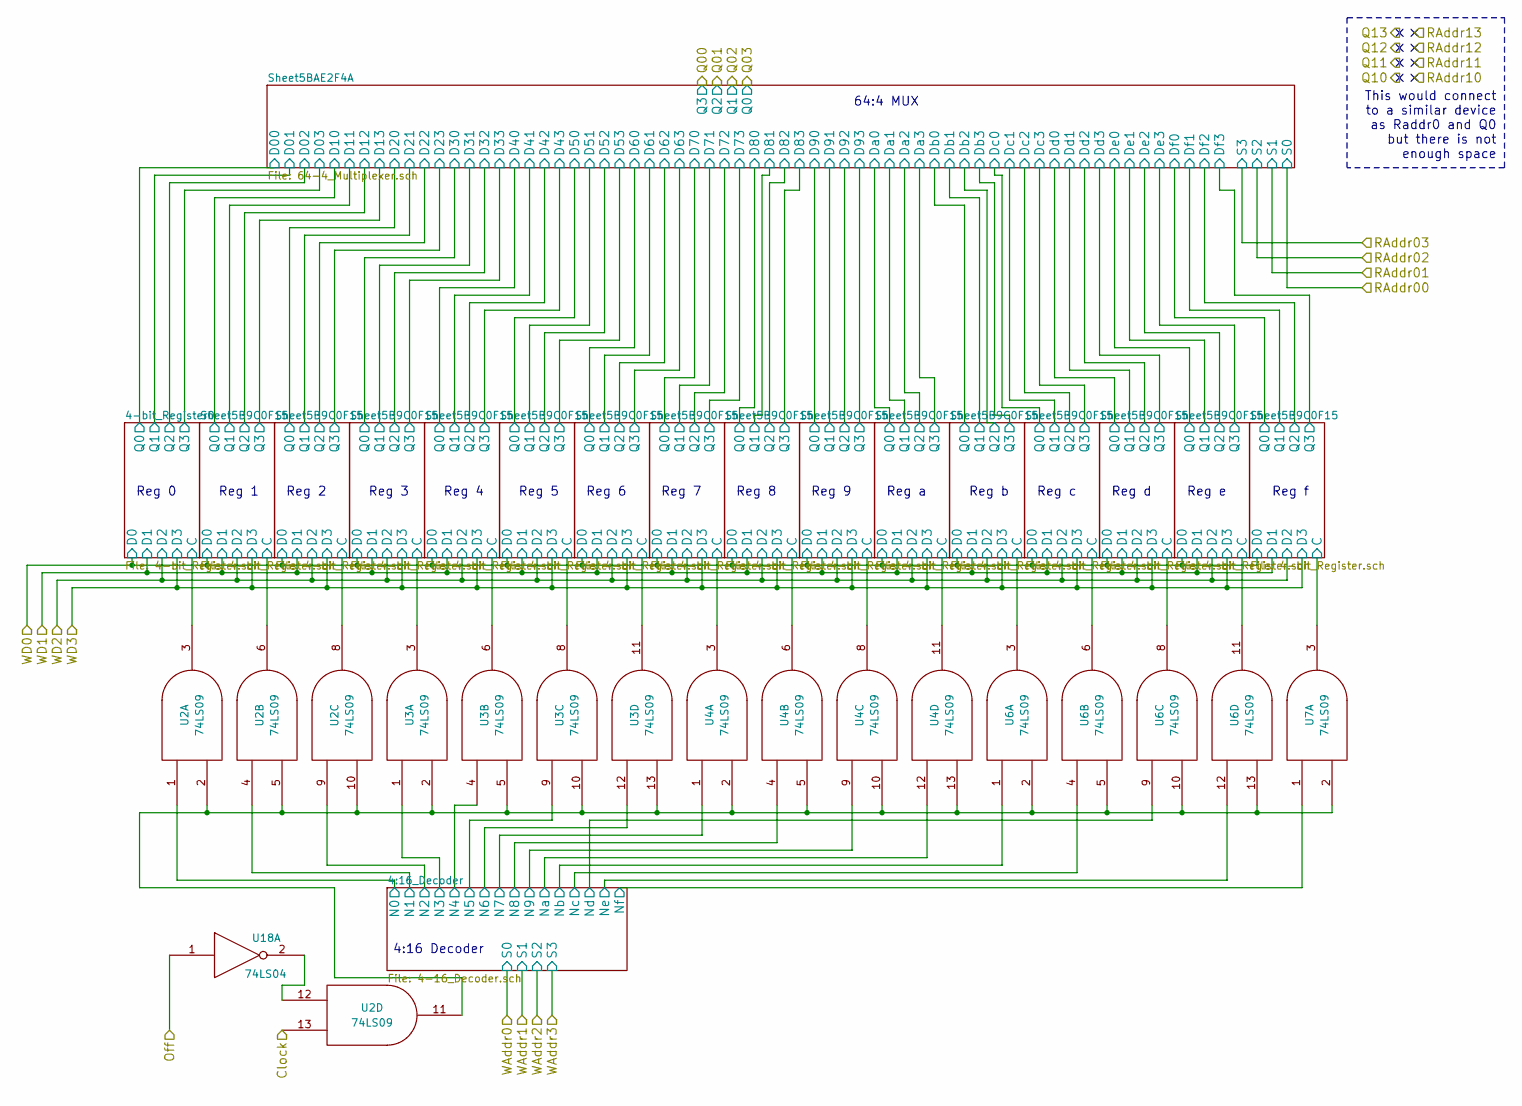
[picture p12: schematic Registers-2018-09-18-09-34-03.sch]

Parts:
U2, U3, U4, U6, U7: 74LS09
U18: 74LS04

Connections:
C: U2.3, U2.6, U2.8, U3.3, U3.6, U3.8, U3.11, U4.3, U4.6, U4.8, U4.11, U6.3, U6.6, U6.8, U6.11, U7.3
Clock: U2.13
N0: U2.1
N1: U2.4
N2: U2.9
N3: U3.1
N4: U3.4
N5: U3.9
N6: U3.12
N7: U4.1
N8: U4.4
N9: U4.9
Na: U4.12
Nb: U6.1
Nc: U6.4
Nd: U6.9
Ne: U6.12
unnamed: U2.2, U2.5, U2.10, U2.11, U3.2, U3.5, U3.10, U3.13, U4.2, U4.5, U4.10, U4.13, U6.2, U6.5, U6.10, U6.13, U7.2
unnamed: U2.12, U18.2
Nf: U7.1
Off: U18.1

Notes on the sheet:
This would connect to a similar device as Raddr0 and Q0 but there is not enough space
Reg 0
Reg 1
Reg 2
Reg 3
Reg 4
Reg 5
Reg 6
Reg 7
Reg 8
Reg 9
Reg a
Reg b
Reg c
Reg d
Reg e
Reg f
64:4 MUX
4:16 Decoder
