danielkopp4/4-bit_Processor/Potential Schematics/rescue-backup/half-alu-2018-09-18-09-34-03.sch

## KiCad design Potential Schematics/rescue-backup/half-alu-2018-09-18-09-34-03.sch (2020-09-25)

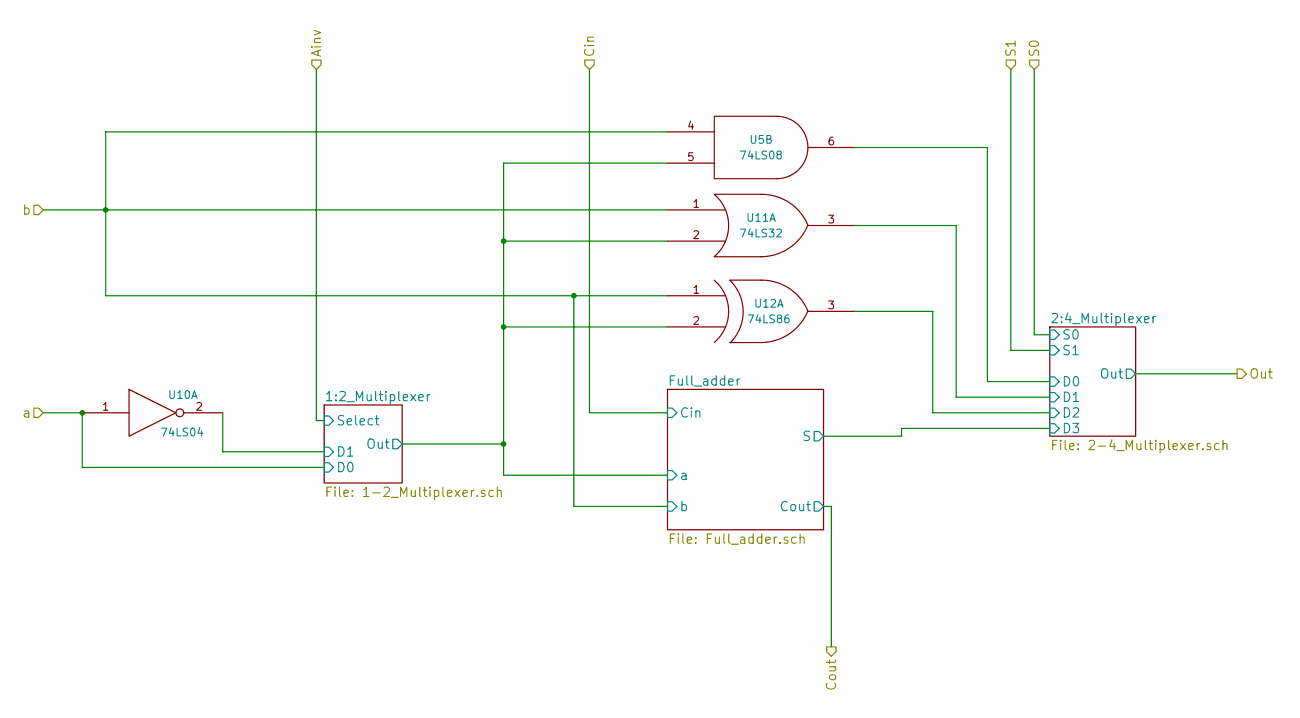
[picture p13: schematic half-alu-2018-09-18-09-34-03.sch]

Parts:
U1: 74LS04
U2: 74LS08
U3: 74LS32
U4: 74LS86

Connections:
D0: U2.6
D1: U1.2, U3.3
D2: U4.3 (OUT)
a: U1.1, U2.5, U3.2, U4.2 (IN2)
b: U2.4, U3.1, U4.1 (IN1)
