danielkopp4/4-bit_Processor/Potential Schematics/rescue-backup/selector-2018-09-18-09-34-03.sch

## KiCad design Potential Schematics/rescue-backup/selector-2018-09-18-09-34-03.sch (2020-09-25)

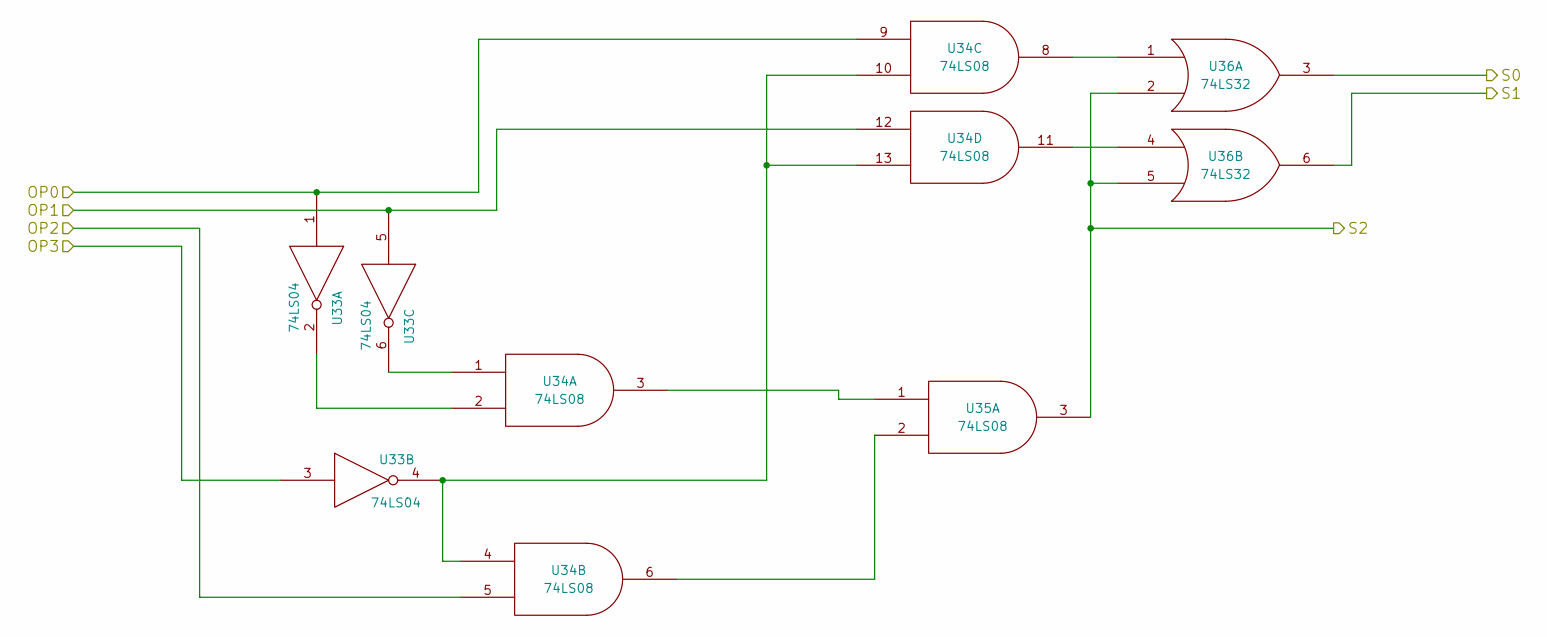
[picture p14: schematic selector-2018-09-18-09-34-03.sch]

Parts:
U33: 74LS04
U34, U35: 74LS08
U36: 74LS32

Connections:
unnamed: U33.2, U34.2
unnamed: U33.4, U34.4, U34.10, U34.13
unnamed: U33.6, U34.1
unnamed: U34.3, U35.1
unnamed: U34.6, U35.2
unnamed: U34.8, U36.1
unnamed: U34.11, U36.4
OP0: U33.1, U34.9
OP1: U33.5, U34.12
OP2: U34.5
OP3: U33.3
S0: U36.3
S1: U36.6
S2: U35.3, U36.2, U36.5
