danielkopp4/4-bit_Processor/(commit log)

2018-09-09 Added assembly code parser v0.01 Beta untested
2018-09-10 Creates frame work for instruction to hex compiler
2018-09-11 Made Half_ALU and Framework
    [1-2_Multiplexer.sch, 2-4_Multiplexer.sch, 4-bit_processor.sch, Full_ALU.sch, Full_adder.sch, half-alu.sch]
2018-09-11 Made an unknown update
    [Full_ALU.sch]
2018-09-14 Made Full ALU
    [1-2_Multiplexer.sch, 2-4_Multiplexer.sch, 4-bit_processor.sch, CPU.sch, Full_ALU.sch, Full_adder.sch, Integer_Overflow_Handler.sch, RS_Latch.sch]
2018-09-15 Made the registers
    [1-2_Multiplexer.sch, 16-1_Multiplexer.sch, 16-1_OR.sch, 16-1_OR_GATE.sch, 2-4_Multiplexer.sch, 4-16_Decoder.sch, 4-bit_Register.sch, 4-bit_processor.sch]
2018-09-16 Added Registers to Top Schematic
    [16-1_Multiplexer.sch, 4-bit_Register.sch, CPU.sch, D_Flip-Flop.sch, D_Latch.sch, RS_Latch.sch]
2018-09-18 Minor Changes
    [CPU.sch]
2018-09-18 Adding Multiply Devide
    [1-2_Multiplexer-2018-09-18-09-34-03.sch, 1-2_Multiplexer.sch, 16-1_Multiplexer-2018-09-18-09-34-03.sch, 16-1_Multiplexer.sch, 16-1_OR_GATE-2018-09-18-09-34-03.sch, 16-1_OR_GATE.sch, 2-4_Multiplexer-2018-09-18-09-34-03.sch, 2-4_Multiplexer.sch]
2018-09-20 Finished PCB
    [1-2_Multiplexer.sch, 16-1_Multiplexer.sch, 16-1_OR_GATE.sch, 2-4_Multiplexer.sch, 4-16_Decoder.sch, 4-bit_Register.sch, 4-bit_processor.sch, 4_Bit_Adder.sch]
2018-09-23 Finished PCB designes for Multiplexer and Registers
    [04s.sch, 1-2_Multiplexer.sch, 16-1_Multiplexer.sch, 16-1_OR.sch, 16-1_OR_GATE.sch, 2-4_Multiplexer.sch, 4_Bit_Adder.sch, 4_IN-ANDsch.sch]
2018-09-23 Updated parser with assembly code instructions
2018-09-24 Updated PCB and is ready to be ordered
    [16-1_Multiplexer.sch, 16-1_OR_GATE.sch, 5-1_AND.sch, Multiplexer.kicad_pcb, Multiplexer_Final_DSN.dsn, PowerFor08s.sch]
2018-09-25 Working on Multiplier
    [1-2_Multiplexer.sch, 16-1_Multiplexer.sch, 16-1_OR_GATE.sch, 2-4_Multiplexer.sch, 3_number_adder.sch, 4-16_Decoder.sch, 4-bit_Register.sch, 4-bit_processor.sch]
2018-09-26 Made Multiplier
    [1-2_Multiplexer.sch, 16-1_Multiplexer.sch, 16-1_OR_GATE.sch, 2-4_Multiplexer.sch, 3_number_adder.sch, 4-16_Decoder.sch, 4-bit_Register.sch, 4-bit_processor.sch]
2018-09-27 Updated overview of Schematic
    [1-2_Multiplexer.sch, 16-1_Multiplexer.sch, 16-1_OR_GATE.sch, 16-4_Multiplexer.sch, 2-4_Multiplexer.sch, 3_number_adder.sch, 4-16_Decoder.sch, 4-1_Mux.sch]
2018-10-03 In the middle of adding ROM
    [1-2_Multiplexer.sch, 16-1_Multiplexer.sch, 16-1_OR_GATE.sch, 16-4_Multiplexer.sch, 2-4_Multiplexer.sch, 3_number_adder.sch, 4-16_Decoder.sch, 4-1_Mux.sch]
